landonnewberry/pen-plotter/README.md

# Pen Plotter Project

## /3D Printed Components
> Fusion 360 F3D files for 3D printed components along with the gcode I used to print each. Some gcode was generated from PrusaSlicer and some was from Cura, depending on the component.
