landonnewberry/pen-plotter/(list of files, cad)

Other CAD files:
3d_printed_components/Axis Body/F3D/Axis Body.f3d
3d_printed_components/Guide Rail and Pulley Tensioner/F3D/Guide Rod Holder and Pulley Tensioner.f3d
3d_printed_components/Mountable Linear Bearing Holder/F3D/Mountable Linear Bearing Holder.f3d
3d_printed_components/NEMA 17 Motor Mount/F3D/NEMA 17 Motor Mount.f3d
3d_printed_components/Y Axis Guide Rail Clamps/F3D/Y Axis Guide Rail Clamps.f3d
3d_printed_components/Y Axis Guide Rail Mount and Motor Mount Holder/F3D/Guide Rail Y Axis Mount and Motor Mount.f3d
