landonnewberry/pen-plotter/3d_printed_components/Axis Body/README.md

# Axis Body

This component is a hub to which 8 `Mountable Linear Bearing Holder` components are attached via M3 metric hex bolts and captive square nuts. 

Linear bearings are inserted into the bearing holders and this `Axis Body` slides up and down Y Axis Guide rails and holds the sliding X Axis Guide Rails.

## Component
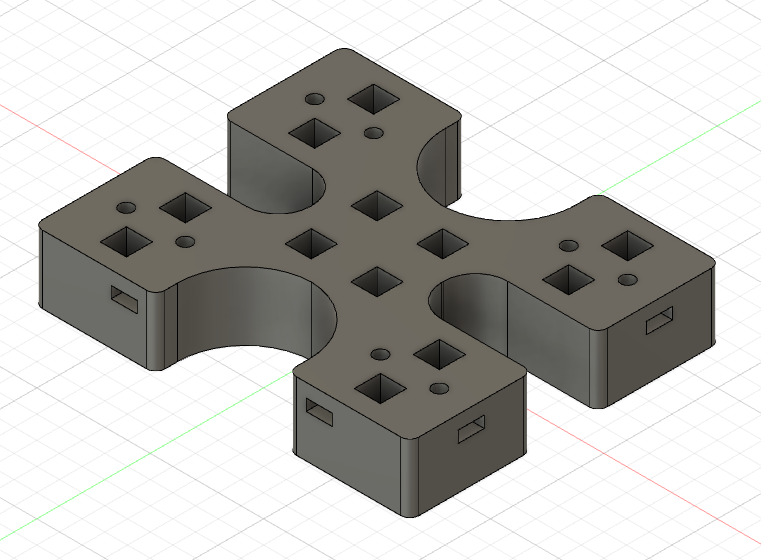
[picture p1: 3d_printed_components/Axis Body/images/origin_view.png]
The Component


## Top Face View
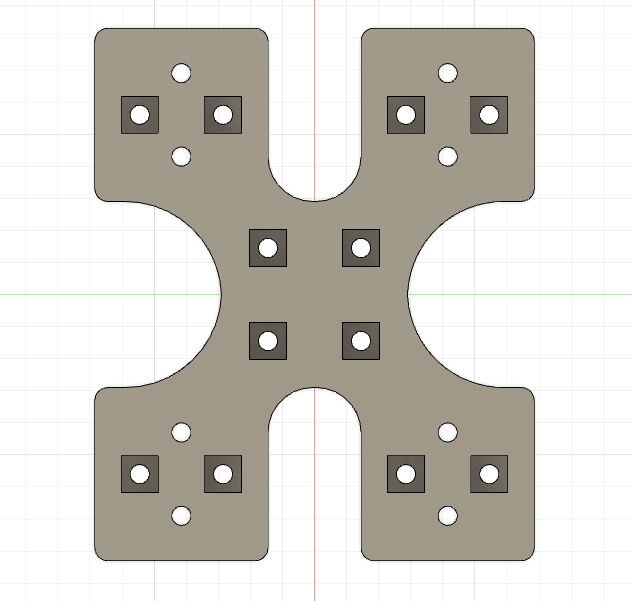
[picture p2: 3d_printed_components/Axis Body/images/top_face_view.png]
Top Face


## Side View Showing Slots for Captive Square Nuts
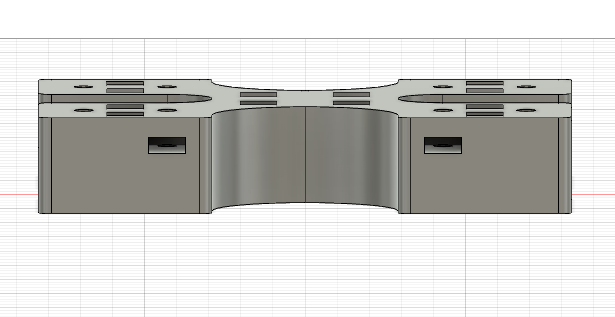
[picture p3: 3d_printed_components/Axis Body/images/side_view_captive_nuts.png]
Side View


## Bottom Face View
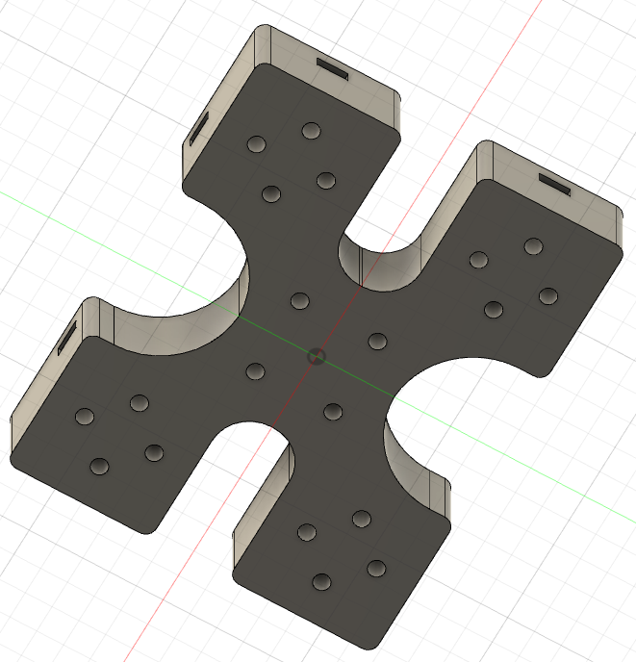
[picture p4: 3d_printed_components/Axis Body/images/bottom_face_view.png]
Bottom Face
