landonnewberry/pen-plotter/3d_printed_components/Guide Rail and Pulley Tensioner/README.md

# Axis Body

This component is attached to the X Axis guide rails using the top rod holding clamps using M3 metric bolts and captive nuts inserted into the slots.

The bottom two slots are meant to hold a 5mm pulley. Once the pulley is looped into the whole system, it will be held stationary here and tensioned via these slots.

## Component
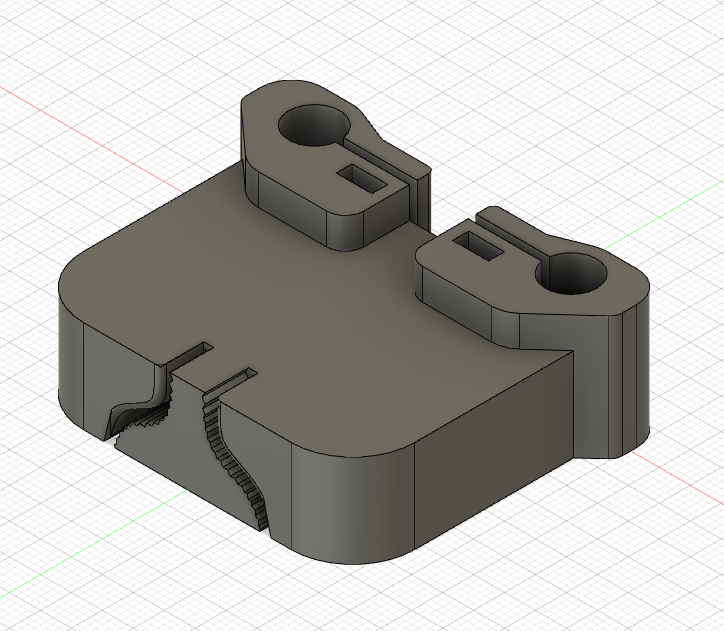
[picture p5: 3d_printed_components/Guide Rail and Pulley Tensioner/images/origin_view.png]
The Component


## Face View
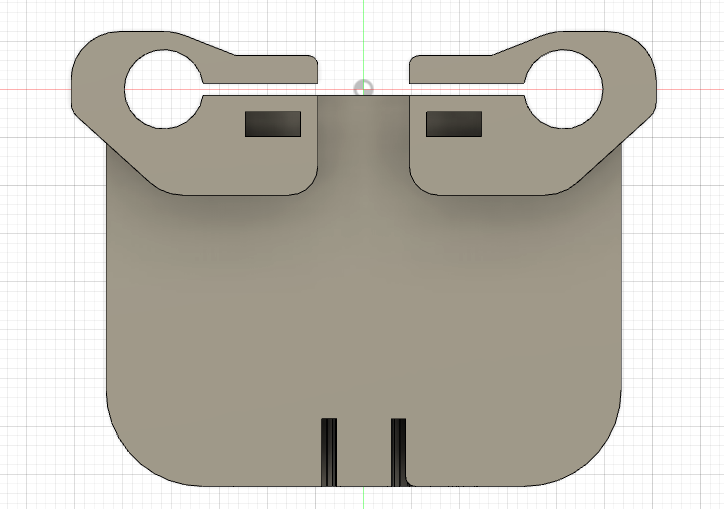
[picture p6: 3d_printed_components/Guide Rail and Pulley Tensioner/images/face_view.png]
Face


## Side View Showing Slots for Pulley Tensioning
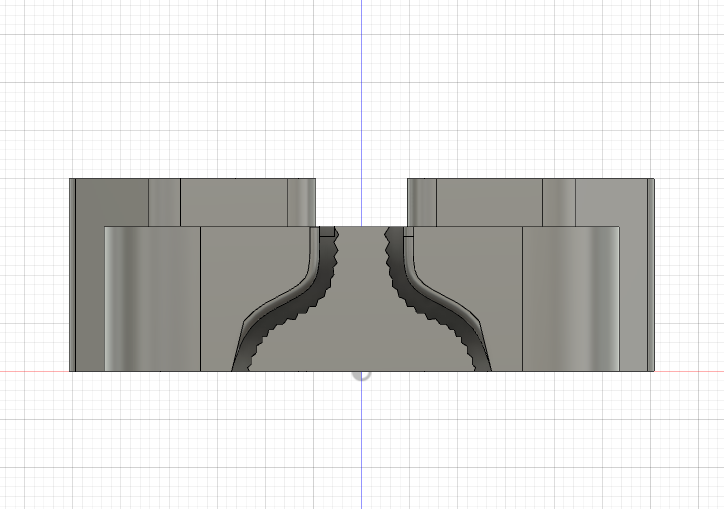
[picture p7: 3d_printed_components/Guide Rail and Pulley Tensioner/images/pulley_tensioner_view.png]
Side View


## Top View Showing Clamping Bolt Holes
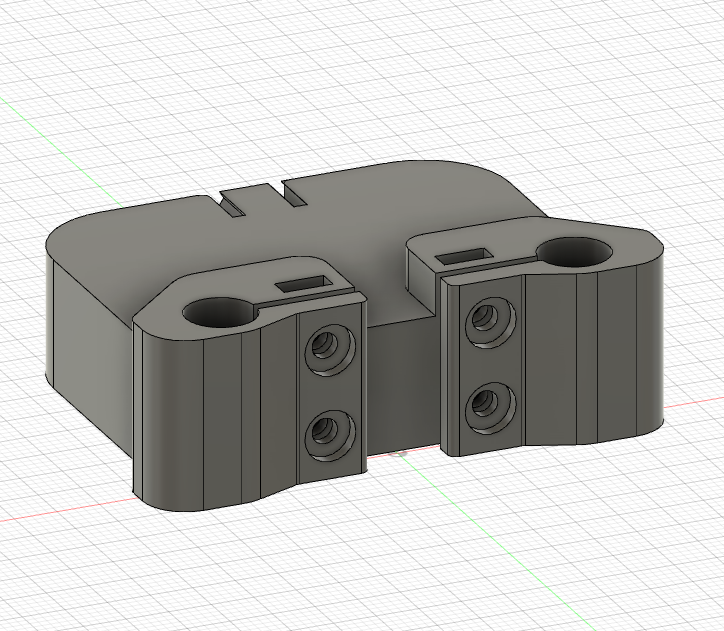
[picture p8: 3d_printed_components/Guide Rail and Pulley Tensioner/images/top_view.png]
Top View
