landonnewberry/pen-plotter/3d_printed_components/Y Axis Guide Rail Clamps/README.md

# Y Axis Guide Rail Clamps

I wanted a way to elevate the Y Axis guide rails above the drawing surface but I didn't want to mount them in the `Y Axis Guide Rail Mount and Motor Mount Holder` components at the end of the Y Axis so I went with this piece. It clamps onto the guide rail and then can bolt into the `Y Axis Guide Rail Mount and Motor Mount Holder`. It's alright, I wouldn't do it again this way.

## Component
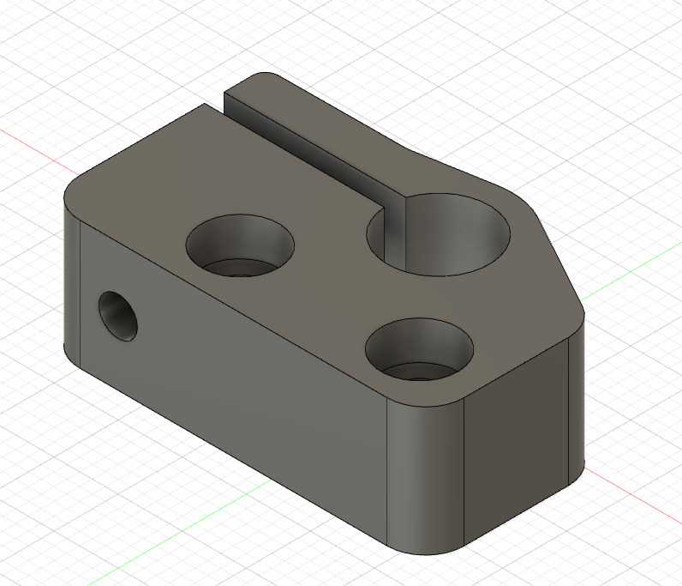
[picture p15: 3d_printed_components/Y Axis Guide Rail Clamps/images/origin_view.png]
The Component


## Other Side View
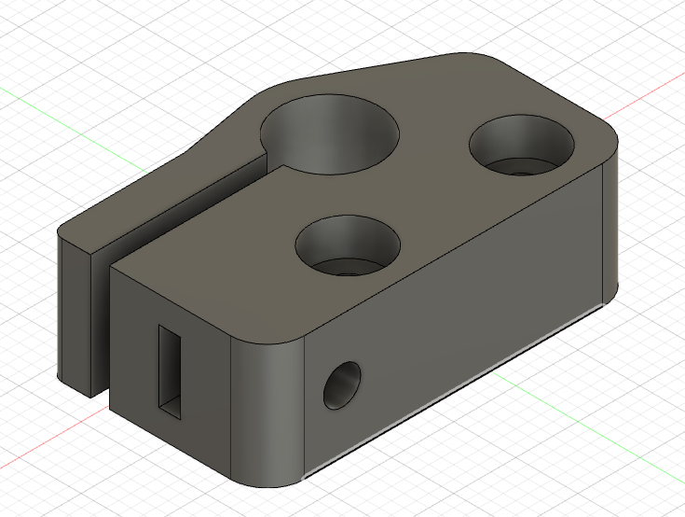
[picture p16: 3d_printed_components/Y Axis Guide Rail Clamps/images/opposite_origin_view.png]
Opposite Origin View


## Top Face Dimensions 1
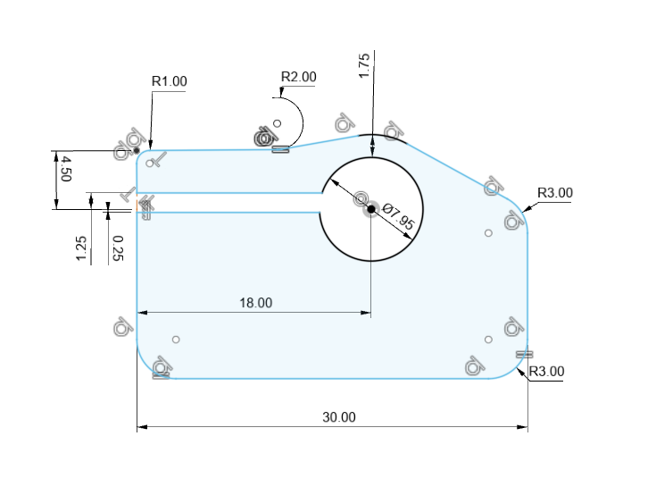
[picture p17: 3d_printed_components/Y Axis Guide Rail Clamps/images/top_view_dimensions_1.png]
Dimensions 1


## Top Face Dimensions 2
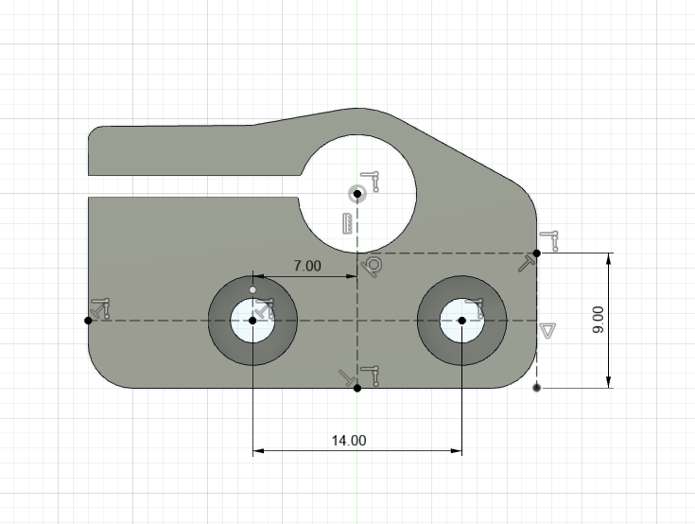
[picture p18: 3d_printed_components/Y Axis Guide Rail Clamps/images/top_view_dimensions_2.png]
Dimensions 2
