landonnewberry/pen-plotter/(commit log)

2021-08-28 forgot an F3D file
    [Guide Rail Y Axis Mount and Motor Mount.f3d]
2021-09-05 fix things i forgot to add
    [motor.py]
2021-09-06 add dockerfile, update to loop for testing, upgraded to 56Ncm holding torque NEMA
